Lircarner/SpectrumAnalyzer/Other/readme.txt

Other project with cc2500 and display
СС2500 module  model is 24TRGC5-V4
