Lircarner/SpectrumAnalyzer/Binary/fuses.jpg

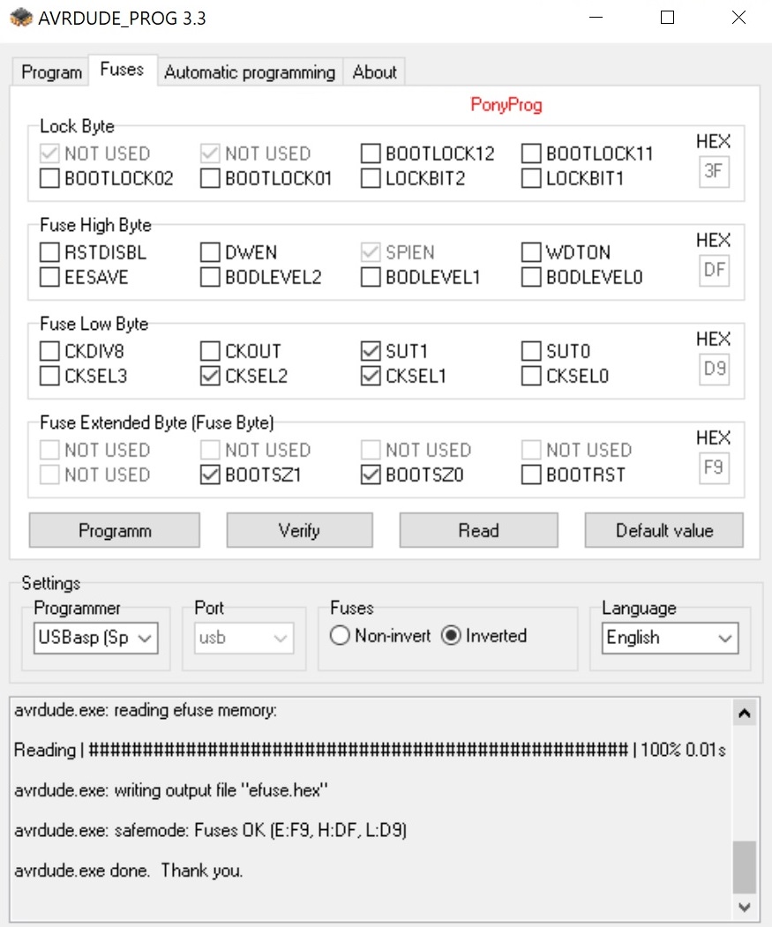
Binary/fuses.jpg
