Lircarner/SpectrumAnalyzer/Other/moduleCircuit.jpg

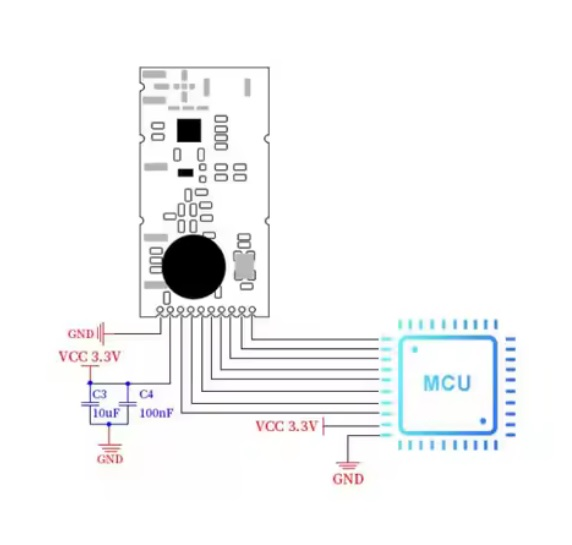
Other/moduleCircuit.jpg
