Lircarner/SpectrumAnalyzer/Pictures/original_circuit.jpg

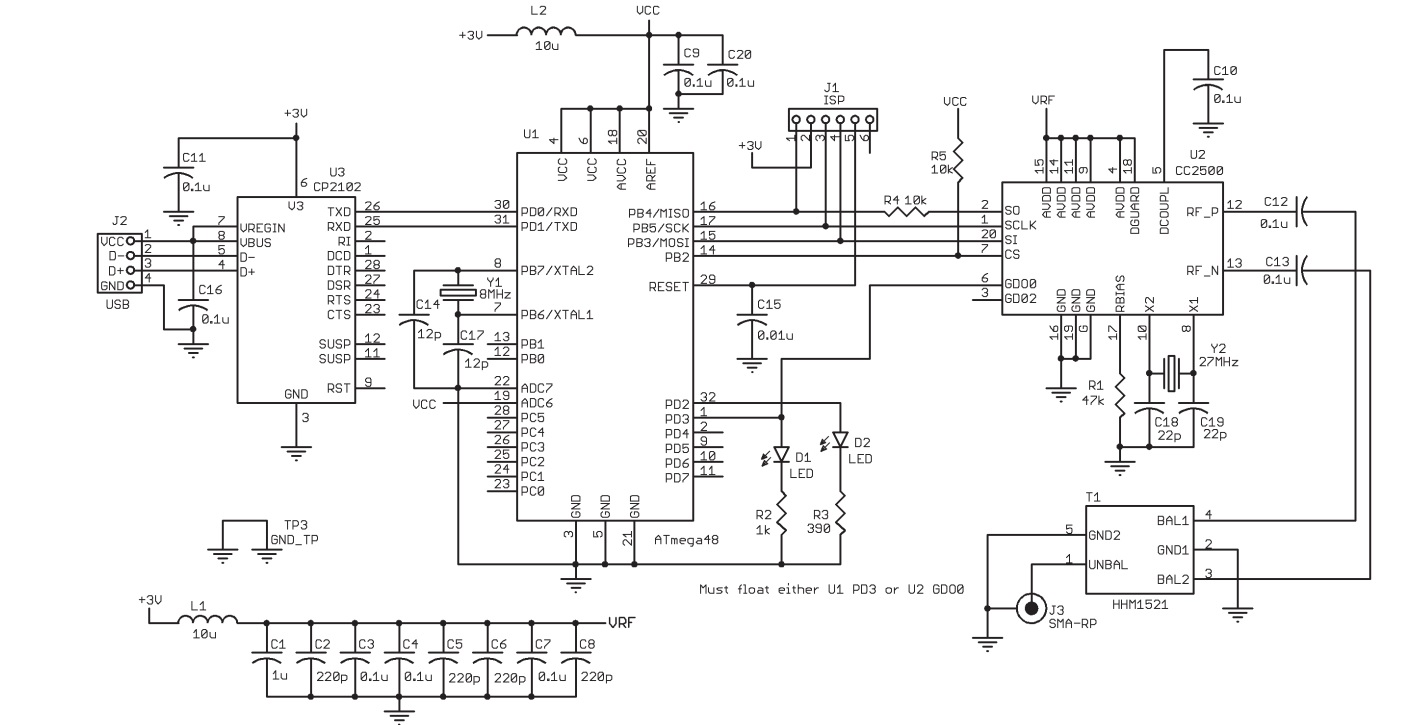
Pictures/original_circuit.jpg
