Lircarner/SpectrumAnalyzer/Pictures/sx-2.jpg

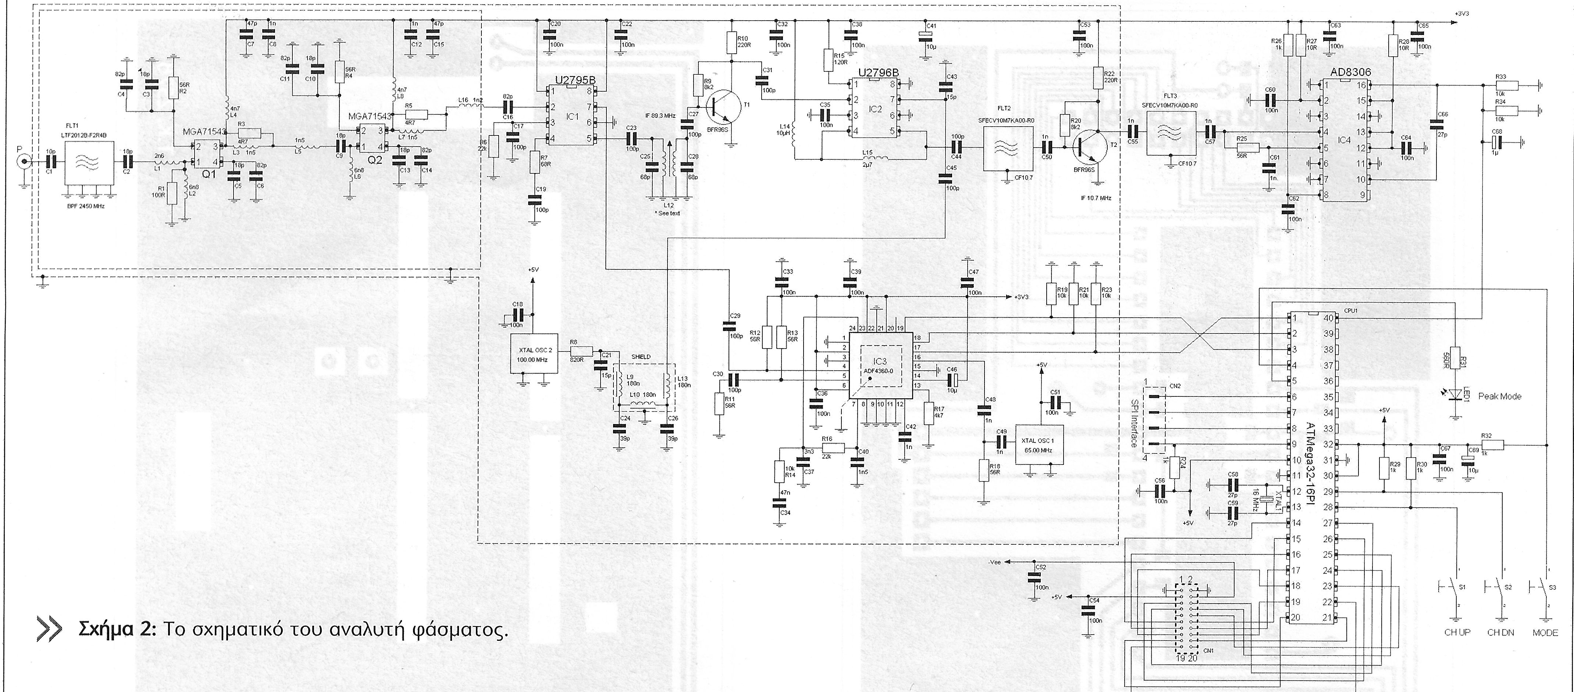
Pictures/sx-2.jpg
