Lircarner/SpectrumAnalyzer/СircuitBoard/board.png

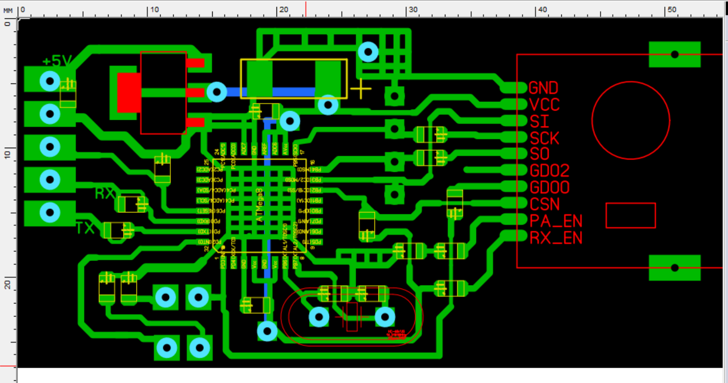
СircuitBoard/board.png
