Lircarner/SpectrumAnalyzer/(list of files, drawings)

Other design files:
СircuitBoard/oldBoard-sl5.lay
СircuitBoard/spectrumBoard.lay6
