Lircarner/SpectrumAnalyzer/(notices)

Notices in the files:
OriginalSources/spectrum.c:
USE OF THE SOFTWARE OR DOCUMENTATION WILL NOT INFRINGE ANY THIRD PARTY PATENTS,
COPYRIGHTS, TRADEMARKS OR OTHER RIGHTS.
